fryefryefrye/MideaTwoWire/README.md

# Midea X1/X2 Two-Wire Bus Protocol

Reverse engineering of the polarity-free two-wire bus between the wired controller and the indoor unit of Midea central air conditioners.

[中文版 (Chinese version)](README.zh-CN.md)

Related project: 
[Midea D1/D2 Protocol](https://github.com/manunited10/midea-d1d2-protocol)

## 1. Project Background

The wall-mounted control panel of a Midea central air conditioner connects to the indoor unit main board through a single two-core wire. This wire carries both power supply and bidirectional communication, and is polarity-free (either wire can be swapped) — a typical private "power + communication" multiplexed bus.

Project goal: tap into this bus with an ESP8266, decode Midea's proprietary protocol (XYE protocol family), and report the AC status.

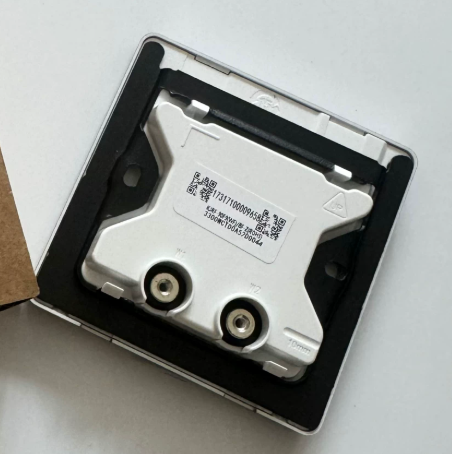
[picture p1: img/image-4.png]


## 2. Physical Layer Findings

Through oscilloscope capture and analysis, the physical layer parameters of the bus were finally confirmed:

| Parameter | Value |
| :--- | :--- |
| Bus DC voltage | approx. 18–20 V |
| Carrier frequency | 200 kHz |
| Carrier amplitude | approx. 1 V peak-to-peak |
| Modulation | OOK / ASK (carrier present/absent represents 0/1) |
| Bit width | approx. 208 µs (4800 bps UART, 1 bit ≈ 208 µs) |
| Bus polarity | None; the two wires are interchangeable |

Final conclusion: the physical layer is essentially a 4800 bps UART signal transmitted via OOK modulation on a 200 kHz carrier.

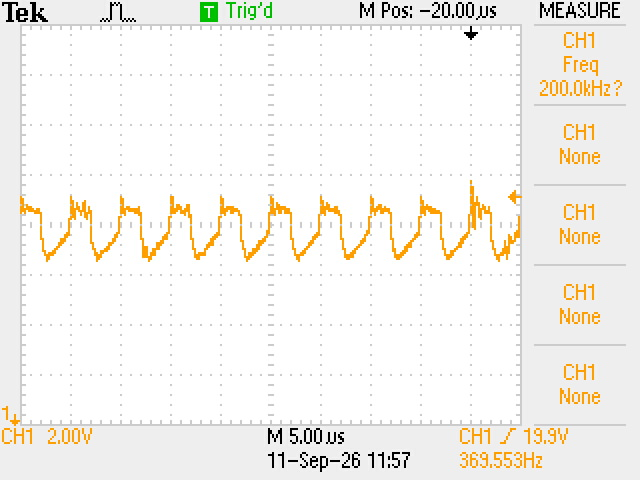
[picture p2: img/F0001TEK.JPG]

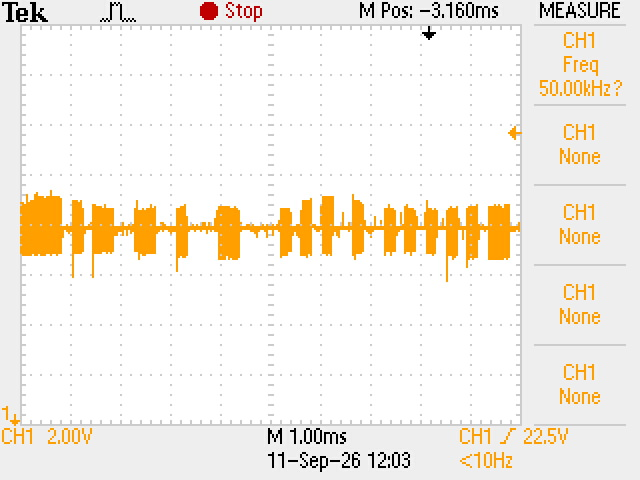
[picture p3: img/F0005TEK.JPG]


## 3. Hardware Design

### 3.1 Signal Chain

Polarity-free bus

    │
    ├──→ Bridge rectifier → Inductor → DC-DC → 3.3 V power supply
    │
    └──→ Coupling capacitor → Bias → Envelope detector → Comparator → ESP8266 GPIO
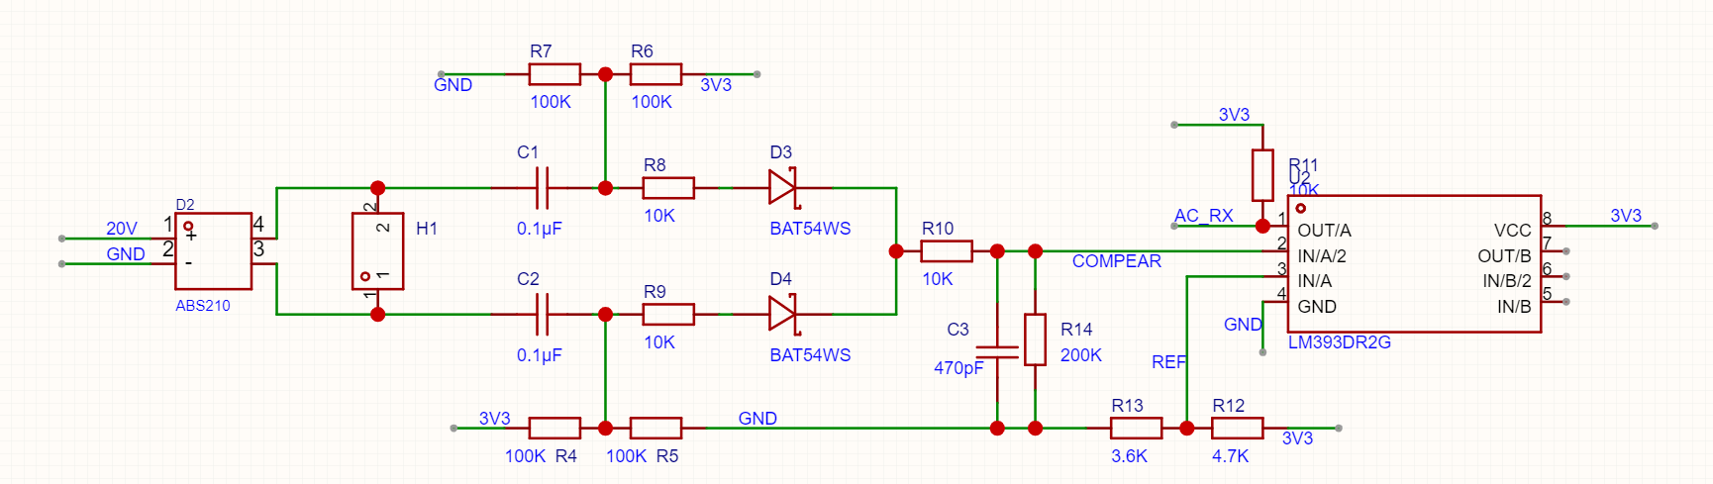
[picture p4: img/image-3.png]

### 3.2 Final Circuit Parameters

DC blocking and biasing:

| Component | Value | Purpose |
| :--- | :--- | :--- |
| C1, C2 | 0.1 µF / 100 V SMD C0G | Block the 20 V DC, pass only the 200 kHz carrier |
| R6/R7, R4/R5 | 100 kΩ + 100 kΩ | Independent bias to 1.65 V, one pair each for A' and B' |

Envelope detection:

| Component | Value | Purpose |
| :--- | :--- | :--- |
| D3, D4 | BAT54S Schottky | Dual-channel detection, handles polarity-free input |
| R10 | 10 kΩ | Charging current limit |
| C3 | 470 pF | Filter out the 200 kHz carrier |
| R_14 | 200 kΩ | Capacitor discharge path |

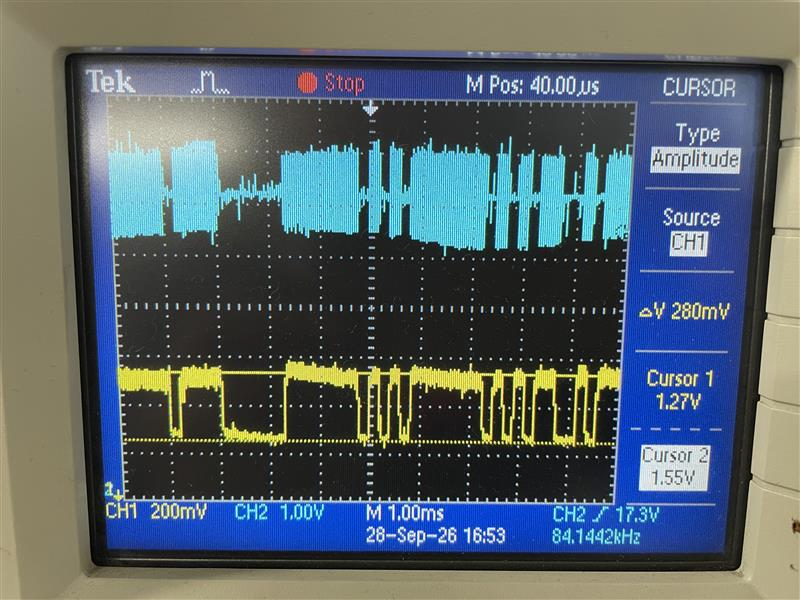
[picture p5: img/image.png]
 

The detected signal swings between 1.55 V and 1.27 V. So 1.41 V was chosen as the comparator reference voltage.

Comparator:

| Component | Value | Purpose |
| :--- | :--- | :--- |
| U1 | LM393 | Open-collector output, low cost |
| R11 | 10 kΩ | Pull-up to 3.3 V |
| R_12/R_13 | 4.7 kΩ / 3.6 kΩ | Voltage divider producing approx. 1.41 V reference |

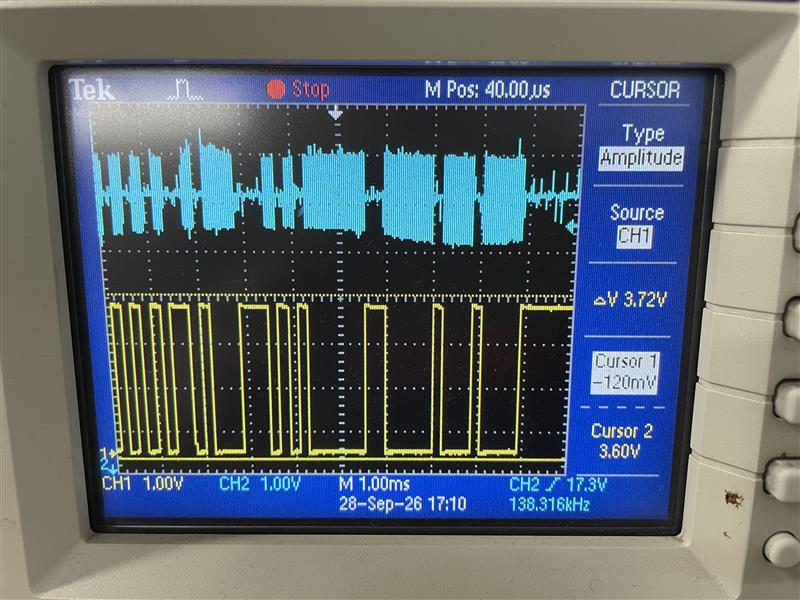
[picture p6: img/image-1.png]
 

The comparator outputs a clean 3.3 V-level signal.

Power supply path:

| Component | Value | Purpose |
| :--- | :--- | :--- |
| Bridge rectifier | ABS210 | Polarity-free rectification |
| Inductor | 470 µH | Isolates the 200 kHz communication signal |
| DC-DC | 20 V → 3.3 V | Powers the ESP8266 |

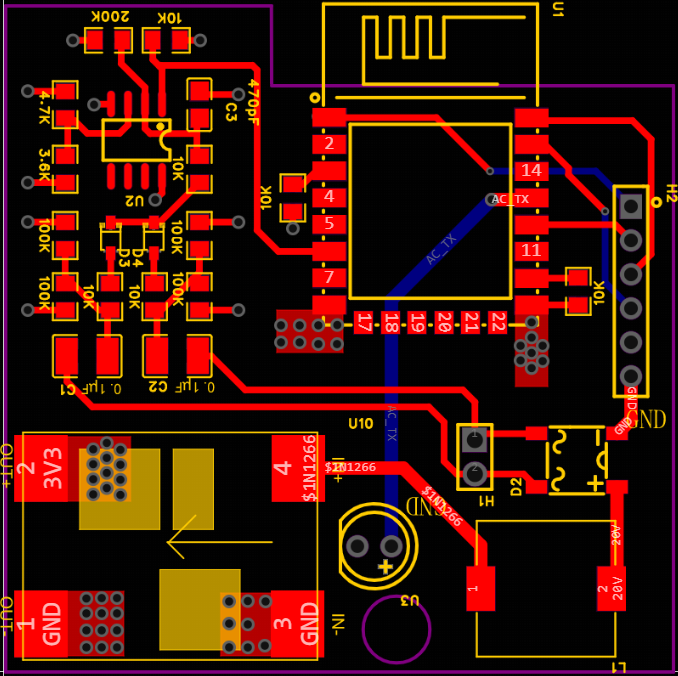
[picture p7: img/image-2.png]


## 4. Protocol Layer Findings: XYE Protocol Family

The demodulated baseband signal is simply a 4800 bps UART stream. The upper-layer protocol is Midea's proprietary XYE protocol family.

### 4.1 Frame Format

[0]         : 0xAA (frame header)

[1]         : Protocol family (e.g. 0x23 / 0x20 / 0x70 / 0x71 / 0x76)

[2..5]      : Source address and destination address (4 bytes)

[6]         : Payload length (DataLen)

[7..N-5]    : Business data segment (DataLen bytes)

[N-4..N-3]  : 2-byte CRC16 checksum (low byte first, high byte second)

[N-2..N-1]  : 0x55 0xFE (frame tail)

### 4.2 CRC Checksum

CRC-16/MODBUS is used:

- Polynomial: 0xA001 (reflected)
- Initial value: 0xFFFF
- Calculation range: from the 2nd byte (skipping the 0xAA frame header) to just before the checksum field (len − 5 bytes in total)

### 4.3 Indoor Unit Status Frame Decoding

Match conditions:

- Frame header fixed at 0xAA
- Frame tail fixed at 0x55 0xFE
- Command family 0x23 (indoor unit communication)
- Source address 0xF8 (indoor unit main board)
- Function code 0x65 (indoor unit operating parameters / status report response)
- Payload length pBuf[6] >= 10

Payload field decoding:

| Byte | Meaning | Decoding |
| :--- | :--- | :--- |
| pData[0] | Mode / power flag | bit6 or bit7 = power on; low 4 bits = mode (0 auto, 1 fan, 2 cool, 3 heat, 6 dry) |
| pData[1] | Fan speed | 0x80 = auto; 0x01–0x07 = levels 1–7 |
| pData[2] | Set temperature | ((b2 & 0xFE) >> 1) − 40 |
| pData[3] | Fan speed (auxiliary) | — |
| pData[4] | Swing / auxiliary status | — |
| pData[9] | — | Not the room temperature; see 4.4 (the old "b9 − 30" formula was unverified) |

Mode flag examples:

- 0x00: power off (Bit 6 = 0)
- 0x42: power on + cooling
- 0x46: power on + dry (dehumidification)
- 0x41: power on + fan only
- 0x43: power on + heating
- 0xC0: power on + auto mode, actually running in cooling

### 4.4 Indoor Unit Room Temperature Frame Decoding

The room temperature is **not** carried by the status frame above; the indoor unit reports it in the `AA 20 F8 ...` frame.

Match conditions:

- Frame header fixed at 0xAA, frame tail fixed at 0x55 0xFE
- Command family 0x20
- Source address 0xF8 (indoor unit main board)
- Payload length pBuf[6] >= 9

Decoding:

| Field | Meaning | Decoding |
| :--- | :--- | :--- |
| pBuf[12], pBuf[13] | Room temperature | signed 16-bit little-endian, in **0.1 °C units** (235 = 23.5 °C) |
| range check | — | only 0 < raw < 600 (0.1–59.9 °C) is accepted; anything else is "no data" (0) |

The value is printed whenever it changes, e.g. `TW Room: 23.5C (raw=235, 0.1C)`.

### 4.5 Software Architecture

Serial reception:

- SoftwareSerial receives the 4800 bps UART data
- A 10 ms inter-frame idle timeout marks a frame as complete
- 256-byte receive buffer

Decoding flow:

1. Validate the whole frame (header, tail, length, CRC16)
2. Decode the room temperature from the `AA 20 F8 ...` frame, and print it when it changes
3. Match the indoor unit status response command (`AA 23 F8 ... 65 ...`)
4. Extract the payload and compare with the previous data to detect changes
5. Decode power state, mode, set temperature, and fan speed

## 5. Key Problems and Solutions

### 5.1 Bridge Rectifier Power Supply Interferes with Communication

Symptom: after connecting the bridge rectifier + DC-DC, the panel and the main board could no longer communicate.

Cause: the DC-DC input capacitor presents a low impedance to the 200 kHz signal, short-circuiting the communication signal.

Solution: insert a 470 µH inductor between the bridge rectifier positive output and the DC-DC input to isolate the 200 kHz signal.

## 6. Final Results

- Physical layer parameters fully confirmed (200 kHz OOK, 20 V bus, polarity-free)
- Confirmed the physical layer is essentially a 4800 bps UART
- Demodulation circuit works properly; the comparator outputs clean 0/3.3 V baseband pulses
- Power supply and communication do not interfere with each other
- Successfully reverse-engineered the XYE protocol family frame format and CRC16 checksum
- Implemented indoor unit status frame decoding (power, mode, set temperature, fan speed)
- Implemented room temperature decoding from the `AA 20 F8 ...` frame (0.1 °C resolution)

## 7. Significance

This project covers the complete workflow of "physical layer reverse engineering → demodulation circuit design → protocol reverse engineering → software implementation → Home Assistant integration", providing a fully reproducible solution for smart-home retrofit of Midea's two-wire polarity-free bus.

The core challenges were small-signal handling on a polarity-free bus, the discharge path design of the envelope detector, and the isolation between power and communication. Once the physical layer was confirmed to be a 4800 bps UART, the protocol reverse engineering became systematic, and both the XYE protocol family frame format and the CRC16 checksum were successfully decoded.

## 8. Off-the-Shelf Alternative: MAX22088

If you would rather not build the discrete analog front end, there is an integrated option: the Analog Devices **MAX22088** (and the pin-compatible MAX22288), an HBS (Home Bus System) compatible transceiver. It puts the whole physical layer into one chip — most notably an **active inductor** that removes the bulky external AC-blocking inductor, plus an integrated 5 V linear regulator (up to 70 mA) to power the node, dynamic cable termination, and adjustable receiver hysteresis/thresholds. Up to 200 kbps, 24-pin 4 mm × 4 mm TQFN, −40 °C to +105 °C.

Why this project still uses a discrete front end:

| Aspect | MAX22088 | Discrete front end (this project) |
| :--- | :--- | :--- |
| Chip price | ~$3.63 at 1ku; $7.94–$14.28 for single units | — |
| Evaluation kit | $104–$183, two boards (master + remote), ±1 kV surge tested | — |
| Board-level cost | the transceiver alone dominates the BOM | a few passive components only |
| Assembly | 4 mm × 4 mm TQFN, needs hot air / reflow | SOIC / through-hole, hand-solderable |
| Bring-up | Low: the front end is standardized | Higher: needs a scope and stage-by-stage analog debugging |

Notes:

- For a quick physical-layer validation (checking whether the Midea X1/X2 bus really works with this transceiver), the MAX22088 EVKIT is the lowest-risk route — schematics and PCB layout are public.
- Official resources: driver plus a `two_nodes` master/slave example — <https://github.com/analogdevicesinc/max22x88-driver>; application note *How to Transmit UART Packets Using a Home Bus System (HBS) Compatible Transceiver* — <https://www.analog.com/en/design-notes/how-to-transmit-uart-packets-using-a-home-bus-system-hbs-compatible-transceiver.html>
- Bottom line: the MAX22088 standardizes the "dirty work" of the physical layer and is a great reference/validation starting point, but it is not a chip optimized for low-cost DIY. For a finished build, the discrete approach described above is usually the better trade-off.

## 9. Field Deployment: Adapter Boards Hidden Inside the Controller

### 9.1 Background: Two Generations of Controllers (4-Wire and 2-Wire)

Older Midea controllers are **4-wire**: the control board sends a **38 kHz infrared control signal** to the indoor unit through two of the wires (essentially an IR remote link stretched out to the indoor unit), and the control board itself also receives the handheld remote's signal.

Newer Midea units have all moved to the **polarity-free two-wire version** (the X1/X2 bus covered by this project): power supply and bidirectional communication share the same two wires.

### 9.2 4-Wire Adapter Board

For the older 4-wire units, the ESP8266 adapter board:

- Monitors the upstream 38 kHz IR control signal (controller → indoor unit) by tapping the **raw IR drive signal with the carrier still on it** — the 38 kHz is stripped in software (software envelope detector)
- Uses an on-board IR LED to send control commands to the AC
- Slips into the gap of the controller enclosure for a hidden installation
- **Deployed on nearly 100 units**

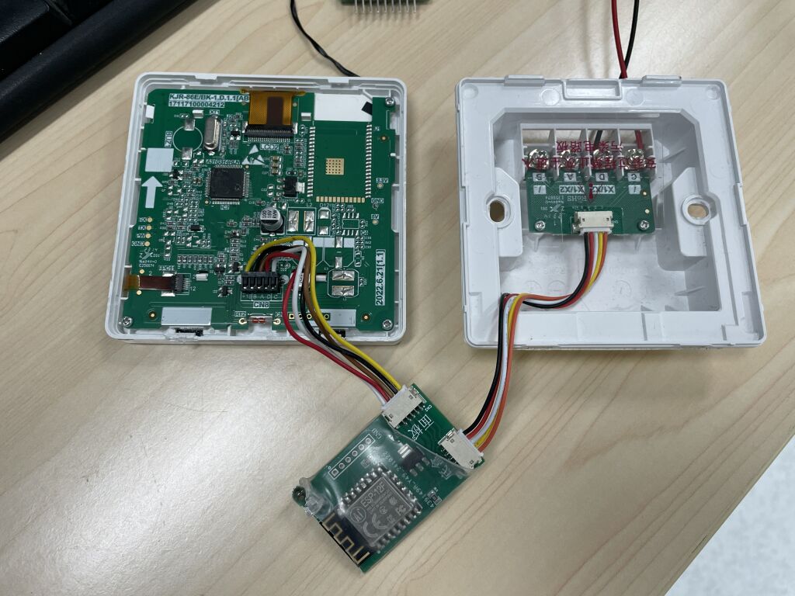
[picture p8: img/controller-4wire.jpg]
4-wire controller with adapter board


### 9.3 2-Wire Adapter Board (This Project)

For the new polarity-free two-wire units:

- **Powered from the control line**: bridge rectifier + isolating inductor + DC-DC (see Section 3)
- **Demodulates bidirectional communication**: envelope detector + comparator recover the 4800 bps UART; the XYE protocol frames yield the operating status (power, mode, set temperature, fan speed, room temperature)
- **Control is still sent via the IR LED**
- Also slips into the gap of the controller enclosure — **deployment has just started**

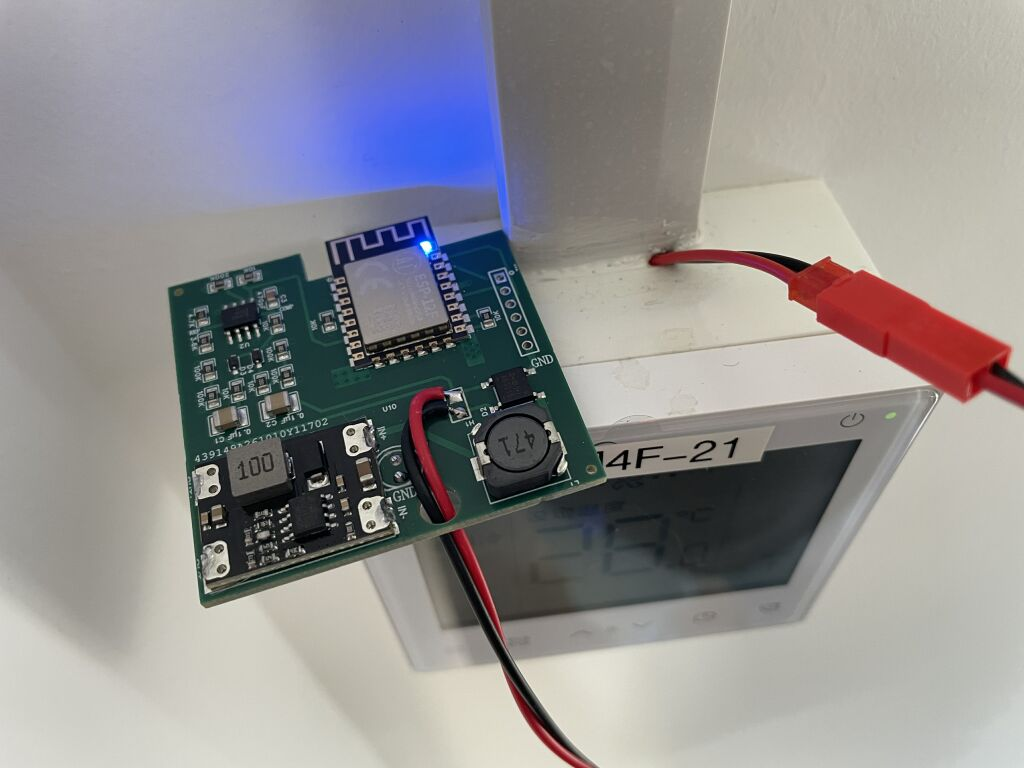
[picture p9: img/controller-2wire.jpg]
2-wire controller with adapter board


The two boards follow the same philosophy: status monitoring goes over the wiring (IR signal monitoring on the 4-wire units, bus communication demodulation on the 2-wire units), control always goes through the IR LED, and both are built as hidden boards that fit inside the controller's gap.

## 10. Example Code

Minimal, self-contained Arduino sketches (ESP8266) live in [`examples/`](examples/). Each folder is a plain Arduino project (`.ino` in the folder root) that opens directly in the Arduino IDE and also builds with PlatformIO.

| Example | Bus | What it does |
| :--- | :--- | :--- |
| [01_ir38k_decode](examples/01_ir38k_decode/) | 4-wire (38 kHz IR signal) | Taps the raw IR drive signal (38 kHz carrier still present) and decodes the 48-bit Midea control frame the wired controller sends to the indoor unit: power, mode, set temperature, fan speed |
| [02_ir_send](examples/02_ir_send/) | IR output (both generations) | Sends AC control commands with an IR LED (the same 48-bit frame format) |
| [03_two_wire_status](examples/03_two_wire_status/) | 2-wire polarity-free X1/X2 bus (this project) | Decodes the XYE protocol frames on the two-wire bus: status, set temperature, fan speed and room temperature |

All three use the same pin convention (`D6` = signal input, `D2` = IR LED output), so they can be combined on one board — which is exactly what the deployed adapter boards do.
