fryefryefrye/MideaTwoWire/(commit log)

2026-09-29 add img of wall-mounted control panel
2026-10-12 update README and code to clarify indoor temperature decoding and implement room temperature reporting
2026-10-16 Add example sketches for Midea wired controller IR decoding and sending
    - Example 01: Midea 38 kHz IR Control Signal Decoder
    - New README.md and platformio.ini files
    - Sketch decodes 48-bit Midea infrared frames for monitoring AC state
    - Example 02: Midea IR Control Sender
    - New README.md and platformio.ini files
    - Sketch sends Midea AC control commands using an IR LED
    - Example 03: Two-Wire Bus AC Status Parser
    - New README.md and platformio.ini files
    - Sketch parses two-wire bus signals to decode AC status and room temperature
    - Added main README.md for examples overview
